zephray/Preader/hardware/front_pcb/front_pcb.kicad_pcb

## KiCad design hardware/front_pcb/front_pcb.kicad_pcb (2021-02-08)

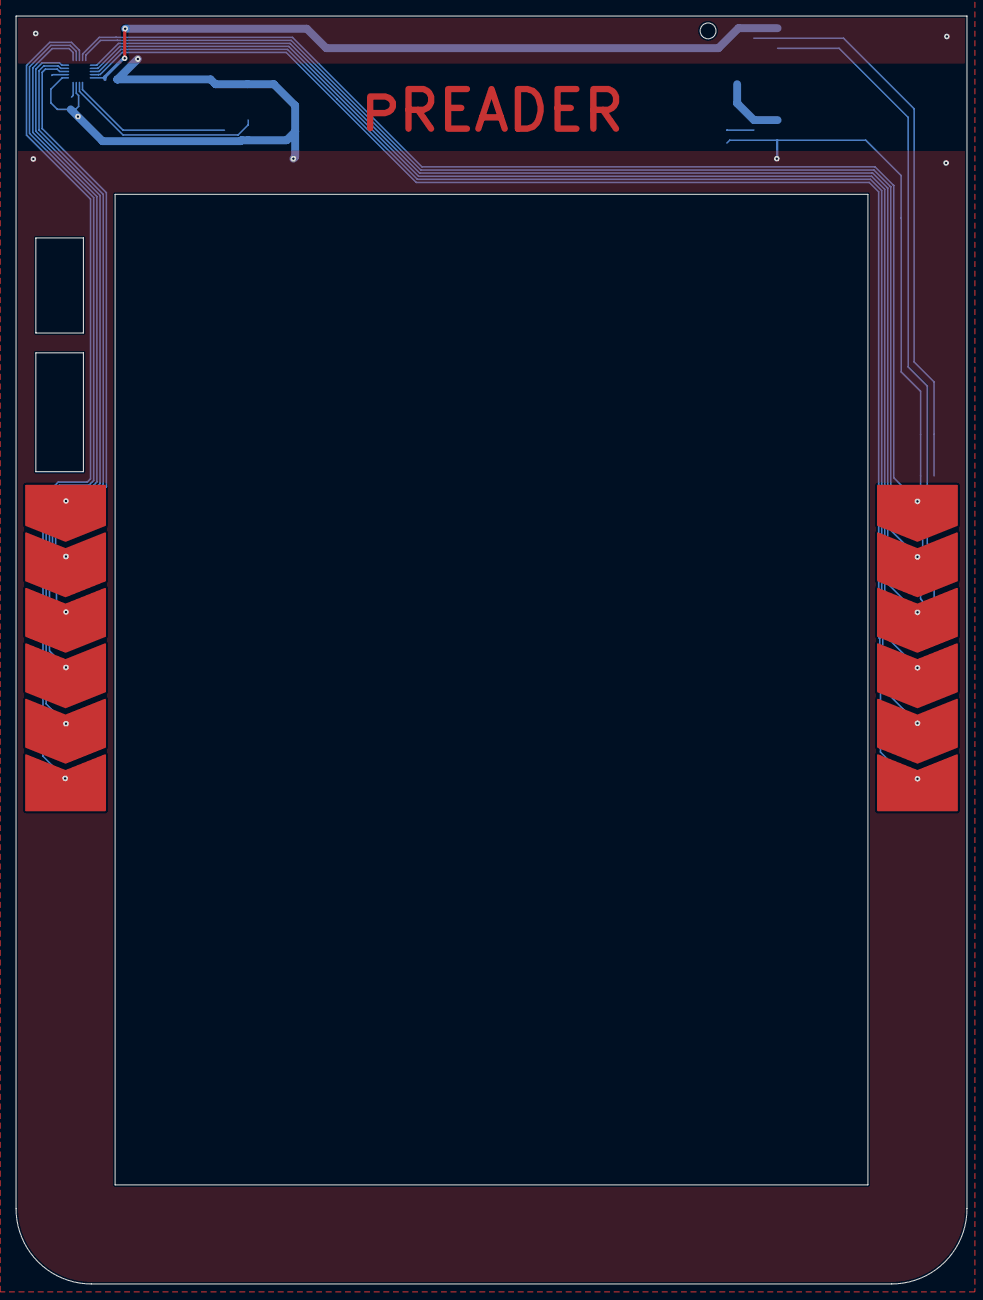
[picture p1: board front_pcb.kicad_pcb from above]

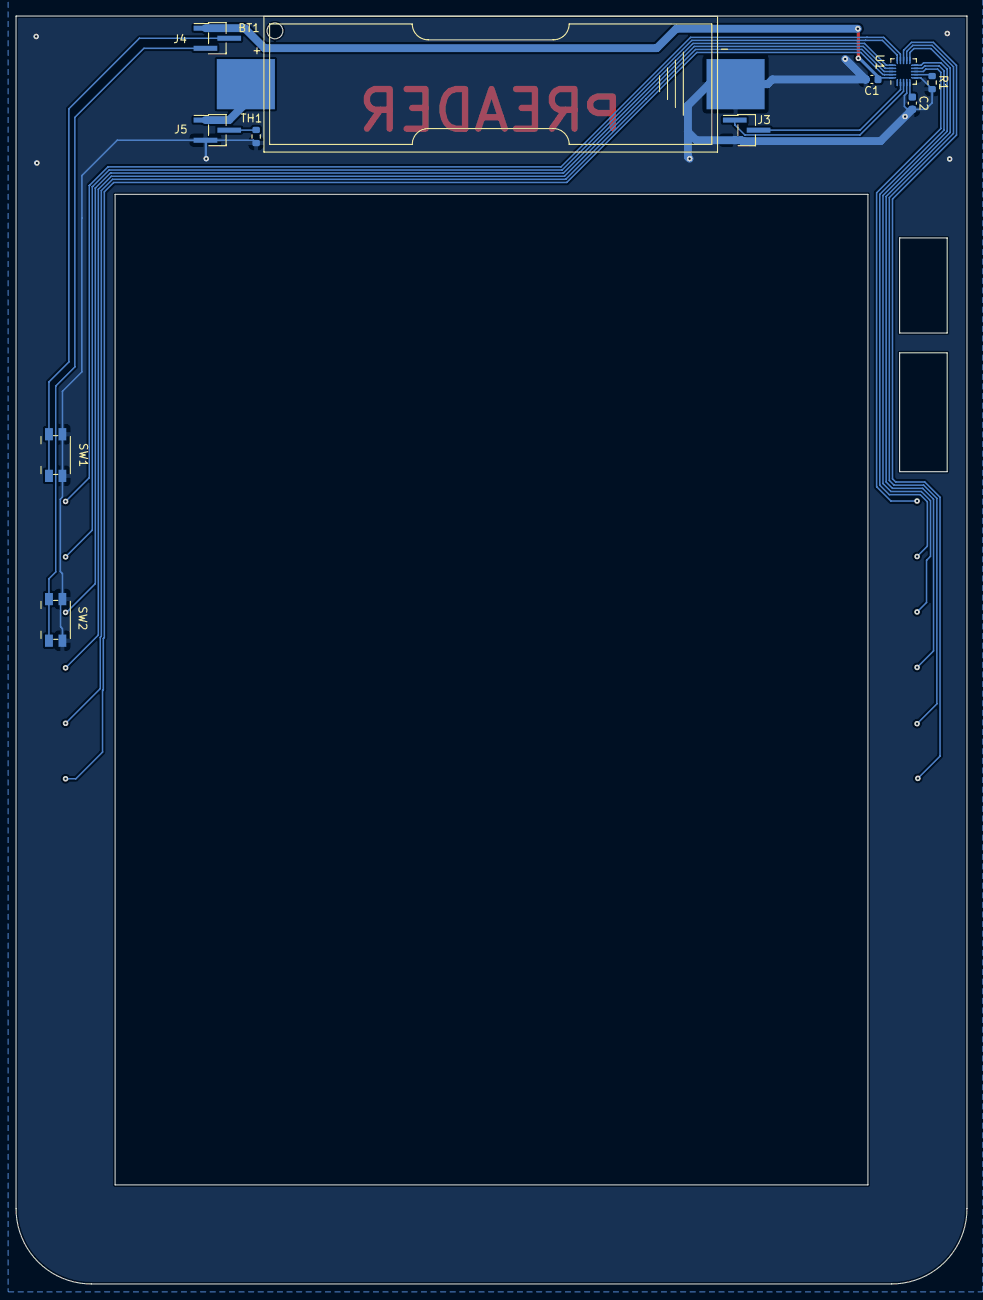
[picture p2: board front_pcb.kicad_pcb from below]

Board: 2 copper layers, 120.0 x 160.0 mm, 13 parts (11 on the bottom side), 22 nets.

Parts:
BT1: Keystone_1088_14800; BatteryHolder_Keystone_1088_1xAA
C1, C2: 100nF; C_0603_1608Metric
J1, J2: Conn_01x06; Touch_Sensing_6PADS
J3, J4, J5: Conn_01x03; PinHeader_1x03_P1.27mm_Vertical_SMD_Pin1Left
R1: 75K/1%; R_0603_1608Metric
SW1, SW2: EVQPUJ02K; Panasonic_EVQPUJ_EVQPUA
TH1: Thermistor_NTC; R_0603_1608Metric
U1: MPR121QR2; UQFN-20_3x3mm_P0.4mm

Connections:
+3V3: C1.1, J4.1, U1.20 (VDD)
+BATT: BT1.1 (+), J5.1
/KEY1: J4.2, SW1.1
/KEY2: J4.3, SW2.1
/KP_SCL: J3.1, U1.3 (SDA)
/KP_SDA: J3.2, U1.2 (SCL)
GND: BT1.2 (-), C1.2, C2.2, J3.3, J5.3, R1.2, SW1.2, SW2.2, TH1.2, U1.4 (ADDR), U1.6 (VSS)
unnamed: C2.1, U1.5 (VREG)
unnamed: J1.1, U1.8 (ELE0)
unnamed: J1.2, U1.9 (ELE1)
unnamed: J1.3, U1.10 (ELE2)
unnamed: J1.4, U1.11 (ELE3)
unnamed: J1.5, U1.12 (LED0/ELE4)
unnamed: J1.6, U1.13 (LED1/ELE5)
unnamed: J2.1, U1.14 (LED2/ELE6)
unnamed: J2.2, U1.15 (LED3/ELE7)
unnamed: J2.3, U1.16 (LED4/ELE8)
unnamed: J2.4, U1.17 (LED5/ELE9)
unnamed: J2.5, U1.18 (LED6/ELE10)
unnamed: J2.6, U1.19 (LED7/ELE11)
unnamed: R1.1, U1.7 (REXT)
unnamed: J5.2, TH1.1
