zephray/Preader/hardware/main_pcb/pcb.kicad_pcb

## KiCad design hardware/main_pcb/pcb.kicad_pcb (2021-02-08)

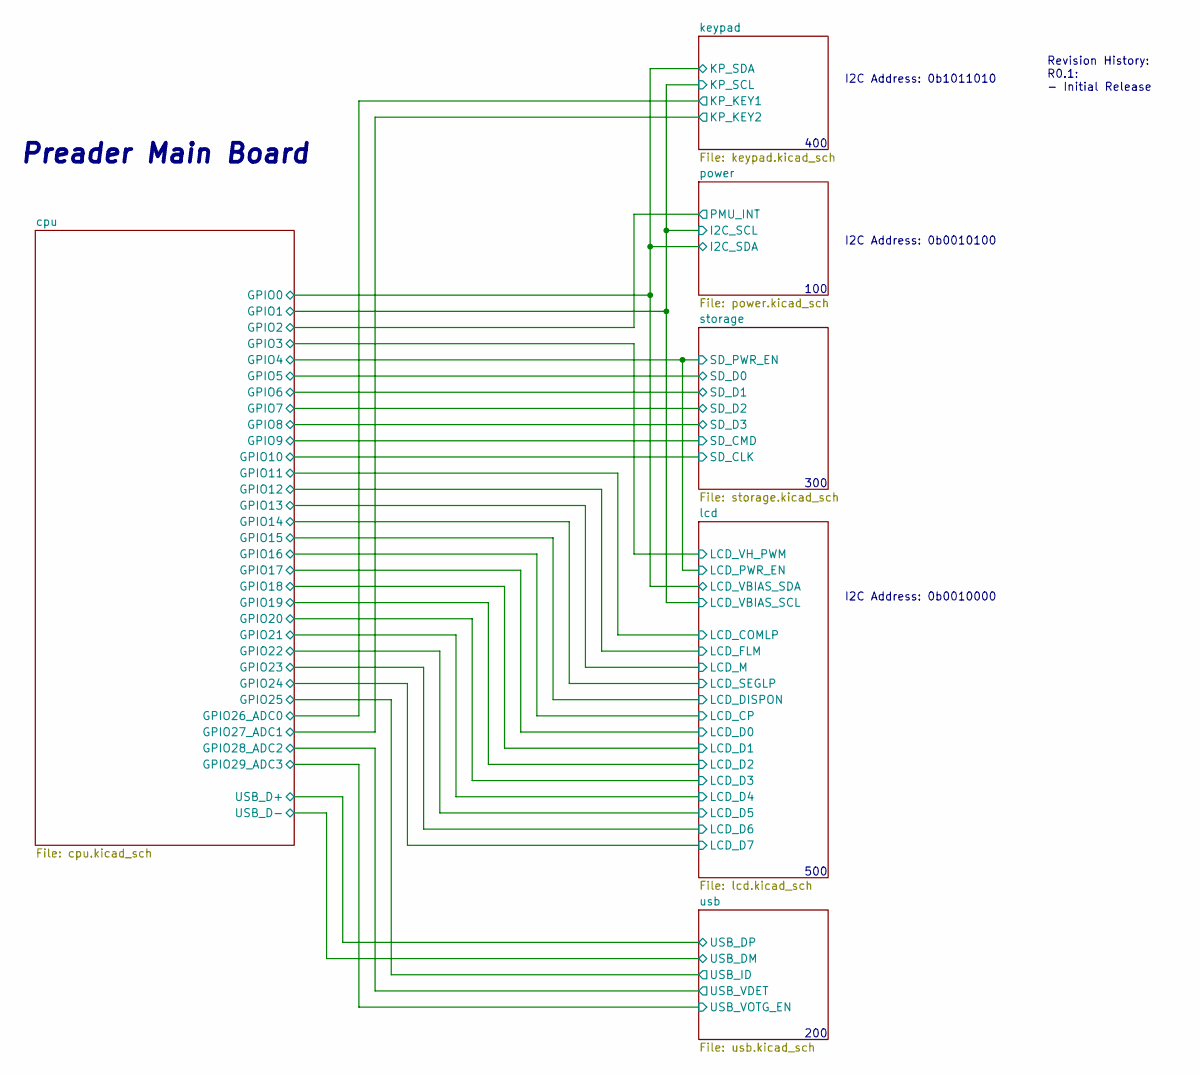
[picture p3: schematic pcb.kicad_sch, Preader MB]

Notes on the sheet:
Preader Main Board
400
100
300
500
200
I2C Address: 0b1011010
I2C Address: 0b0010100
I2C Address: 0b0010000
Revision History: R0.1: - Initial Release

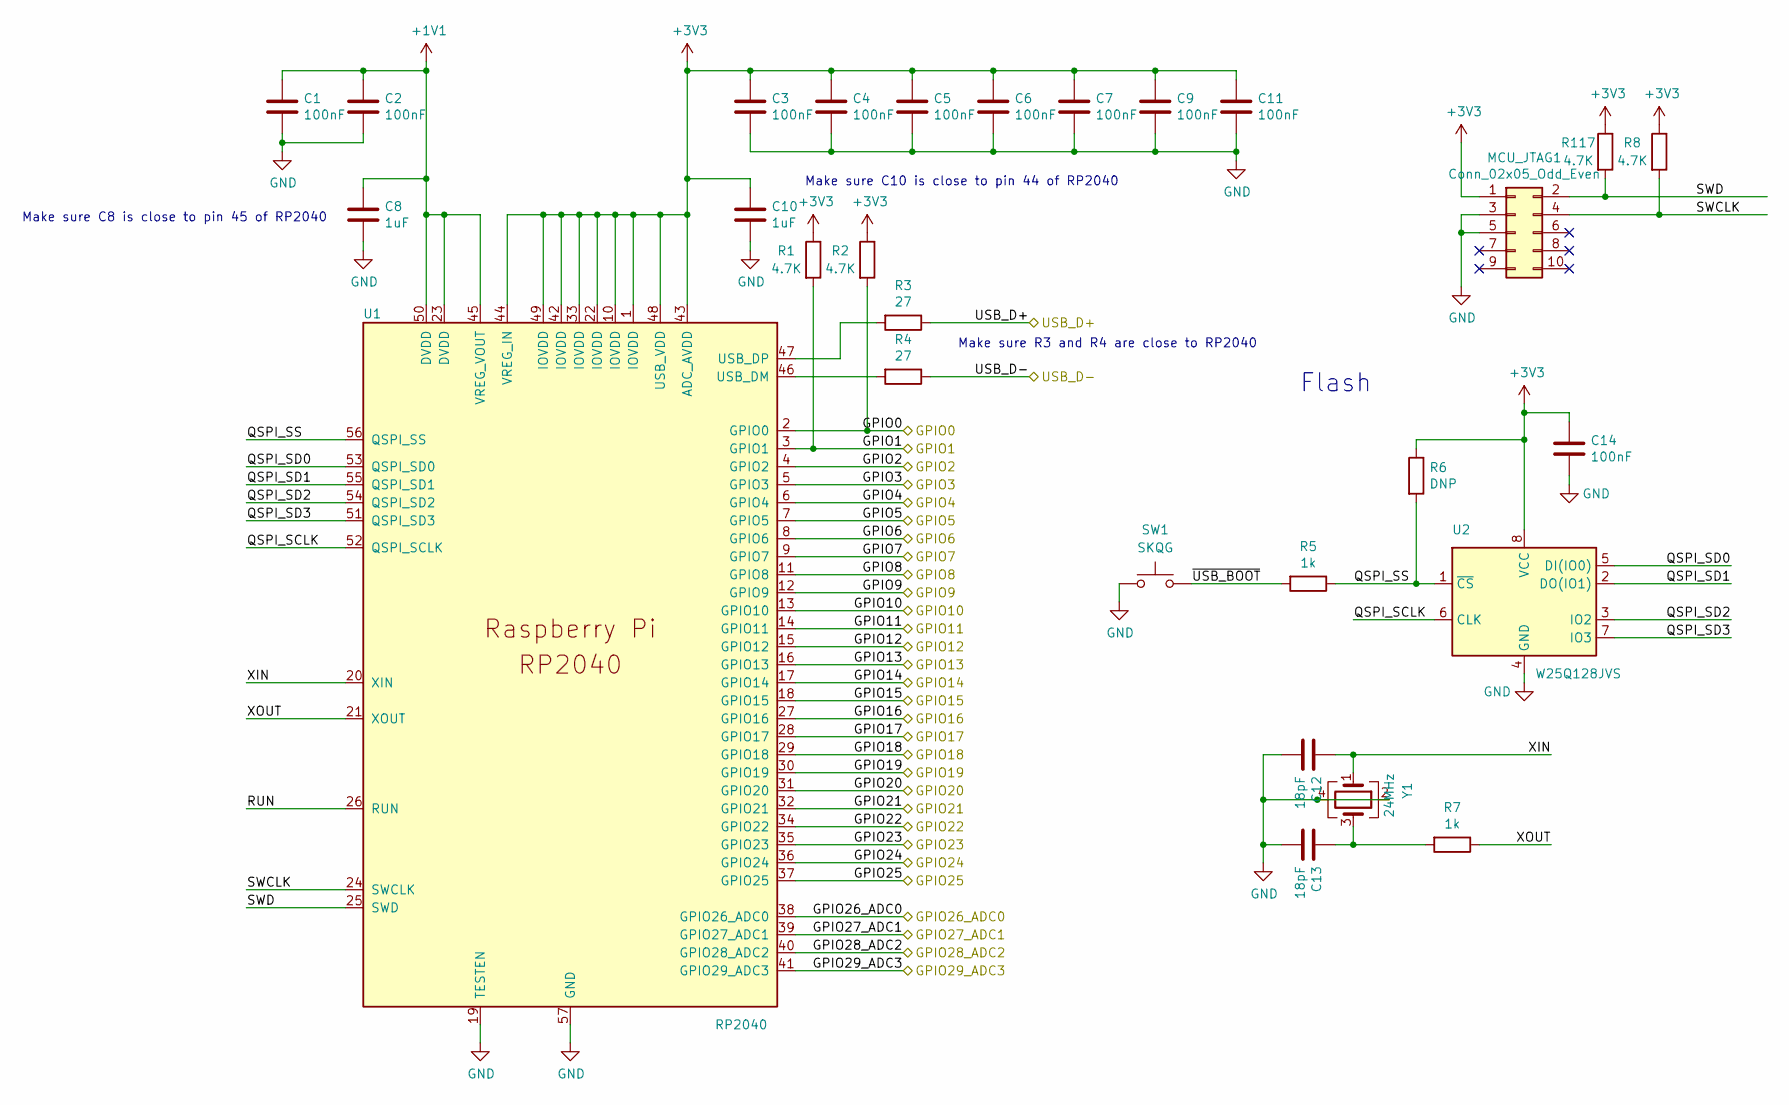
[picture p4: schematic cpu.kicad_sch, InuCal]

Parts:
C1, C2, C3, C4, C5, C6, C7, C9, C11, C14: 100nF; C_0402_1005Metric
C8, C10: 1uF; C_0402_1005Metric
C12, C13: 18pF; C_0402_1005Metric
MCU_JTAG1: Conn_02x05_Odd_Even; PinHeader_2x05_P1.27mm_Vertical_SMD
R1, R2, R8, R117: 4.7K; C_0402_1005Metric
R3, R4: 27; C_0402_1005Metric
R5, R7: 1k; C_0402_1005Metric
R6: DNP; C_0402_1005Metric
SW1: SKQG; SW_SPST_SKQG_WithStem
U1: RP2040; QFN-56-1EP_7x7mm_P0.4mm_EP5.6x5.6mm_ThermalVias
U2: W25Q128JVS; SOIC-8_5.23x5.23mm_P1.27mm
Y1: 24MHz; Oscillator_SMD_Abracon_ASE-4Pin_3.2x2.5mm

Connections:
+1V1: C1.1, C2.1, C8.1, U1.23 (DVDD), U1.45 (VREG_VOUT), U1.50 (DVDD)
+3V3: C3.1, C4.1, C5.1, C6.1, C7.1, C9.1, C10.1, C11.1, C14.1, MCU_JTAG1.1, R1.1, R2.1, R6.1, R8.1, R117.1, U1.1 (IOVDD), U1.10 (IOVDD), U1.22 (IOVDD), U1.33 (IOVDD), U1.42 (IOVDD), U1.43 (ADC_AVDD), U1.44 (VREG_IN), U1.48 (USB_VDD), U1.49 (IOVDD), U2.8 (VCC); also elsewhere on the board
/cpu/GPIO0: R2.2, U1.2 (GPIO0); also elsewhere on the board
/cpu/GPIO1: R1.2, U1.3 (GPIO1); also elsewhere on the board
/cpu/GPIO2: U1.4 (GPIO2); also elsewhere on the board
/cpu/GPIO3: U1.5 (GPIO3); also elsewhere on the board
/cpu/GPIO4: U1.6 (GPIO4); also elsewhere on the board
/cpu/GPIO5: U1.7 (GPIO5); also elsewhere on the board
/cpu/GPIO6: U1.8 (GPIO6); also elsewhere on the board
/cpu/GPIO7: U1.9 (GPIO7); also elsewhere on the board
/cpu/GPIO8: U1.11 (GPIO8); also elsewhere on the board
/cpu/GPIO9: U1.12 (GPIO9); also elsewhere on the board
/cpu/GPIO10: U1.13 (GPIO10); also elsewhere on the board
/cpu/GPIO11: U1.14 (GPIO11); also elsewhere on the board
/cpu/GPIO12: U1.15 (GPIO12); also elsewhere on the board
/cpu/GPIO13: U1.16 (GPIO13); also elsewhere on the board
/cpu/GPIO14: U1.17 (GPIO14); also elsewhere on the board
/cpu/GPIO15: U1.18 (GPIO15); also elsewhere on the board
/cpu/GPIO16: U1.27 (GPIO16); also elsewhere on the board
/cpu/GPIO17: U1.28 (GPIO17); also elsewhere on the board
/cpu/GPIO18: U1.29 (GPIO18); also elsewhere on the board
/cpu/GPIO19: U1.30 (GPIO19); also elsewhere on the board
/cpu/GPIO20: U1.31 (GPIO20); also elsewhere on the board
/cpu/GPIO21: U1.32 (GPIO21); also elsewhere on the board
/cpu/GPIO22: U1.34 (GPIO22); also elsewhere on the board
/cpu/GPIO23: U1.35 (GPIO23); also elsewhere on the board
/cpu/GPIO24: U1.36 (GPIO24); also elsewhere on the board
/cpu/GPIO25: U1.37 (GPIO25); also elsewhere on the board
/cpu/GPIO26_ADC0: U1.38 (GPIO26_ADC0); also elsewhere on the board
/cpu/GPIO27_ADC1: U1.39 (GPIO27_ADC1); also elsewhere on the board
/cpu/GPIO28_ADC2: U1.40 (GPIO28_ADC2); also elsewhere on the board
/cpu/GPIO29_ADC3: U1.41 (GPIO29_ADC3); also elsewhere on the board
/cpu/QSPI_SCLK: U1.52 (QSPI_SCLK), U2.6 (CLK)
/cpu/QSPI_SD0: U1.53 (QSPI_SD0), U2.5 (DI(IO0))
/cpu/QSPI_SD1: U1.55 (QSPI_SD1), U2.2 (DO(IO1))
/cpu/QSPI_SD2: U1.54 (QSPI_SD2), U2.3 (IO2)
/cpu/QSPI_SD3: U1.51 (QSPI_SD3), U2.7 (IO3)
/cpu/QSPI_SS: R5.1, R6.2, U1.56 (QSPI_SS), U2.1 (~CS)
/cpu/RUN: U1.26 (RUN)
/cpu/SWCLK: MCU_JTAG1.4, R8.2, U1.24 (SWCLK)
/cpu/SWD: MCU_JTAG1.2, R117.2, U1.25 (SWD)
/cpu/USB_D+: R3.1; also elsewhere on the board
/cpu/USB_D-: R4.1; also elsewhere on the board
/cpu/XIN: C12.1, U1.20 (XIN), Y1.1
/cpu/XOUT: R7.1, U1.21 (XOUT)
/cpu/~USB_BOOT: R5.2, SW1.2
GND: C1.2, C2.2, C3.2, C4.2, C5.2, C6.2, C7.2, C8.2, C9.2, C10.2, C11.2, C12.2, C13.2, C14.2, MCU_JTAG1.3, MCU_JTAG1.5, SW1.1, U1.19 (TESTEN), U1.57 (GND), U2.4 (GND), Y1.2, Y1.4; also elsewhere on the board
unnamed: C13.1, R7.2, Y1.3
unnamed: R3.2, U1.47 (USB_DP)
unnamed: R4.2, U1.46 (USB_DM)

Notes on the sheet:
Make sure C8 is close to pin 45 of RP2040
Make sure C10 is close to pin 44 of RP2040
Make sure R3 and R4 are close to RP2040
Flash

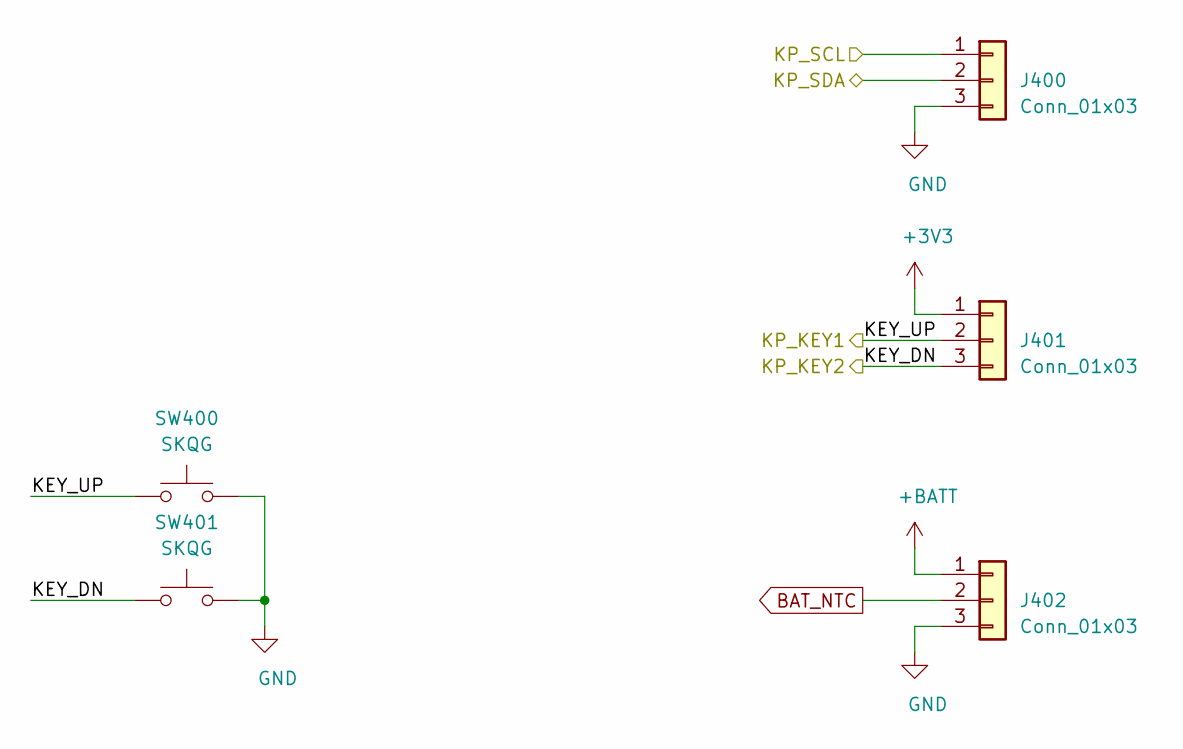
[picture p5: schematic keypad.kicad_sch, InuCal]

Parts:
J400, J401, J402: Conn_01x03; PinHeader_1x03_P1.27mm_Vertical
SW400, SW401: SKQG; SW_SPST_SKQG_WithStem

Connections:
+3V3: J401.1; also elsewhere on the board
+BATT: J402.1; also elsewhere on the board
/cpu/GPIO0: J400.2; also elsewhere on the board
/cpu/GPIO1: J400.1; also elsewhere on the board
/cpu/GPIO26_ADC0: J401.2, SW400.1; also elsewhere on the board
/cpu/GPIO27_ADC1: J401.3, SW401.1; also elsewhere on the board
BAT_NTC: J402.2; also elsewhere on the board
GND: J400.3, J402.3, SW400.2, SW401.2; also elsewhere on the board

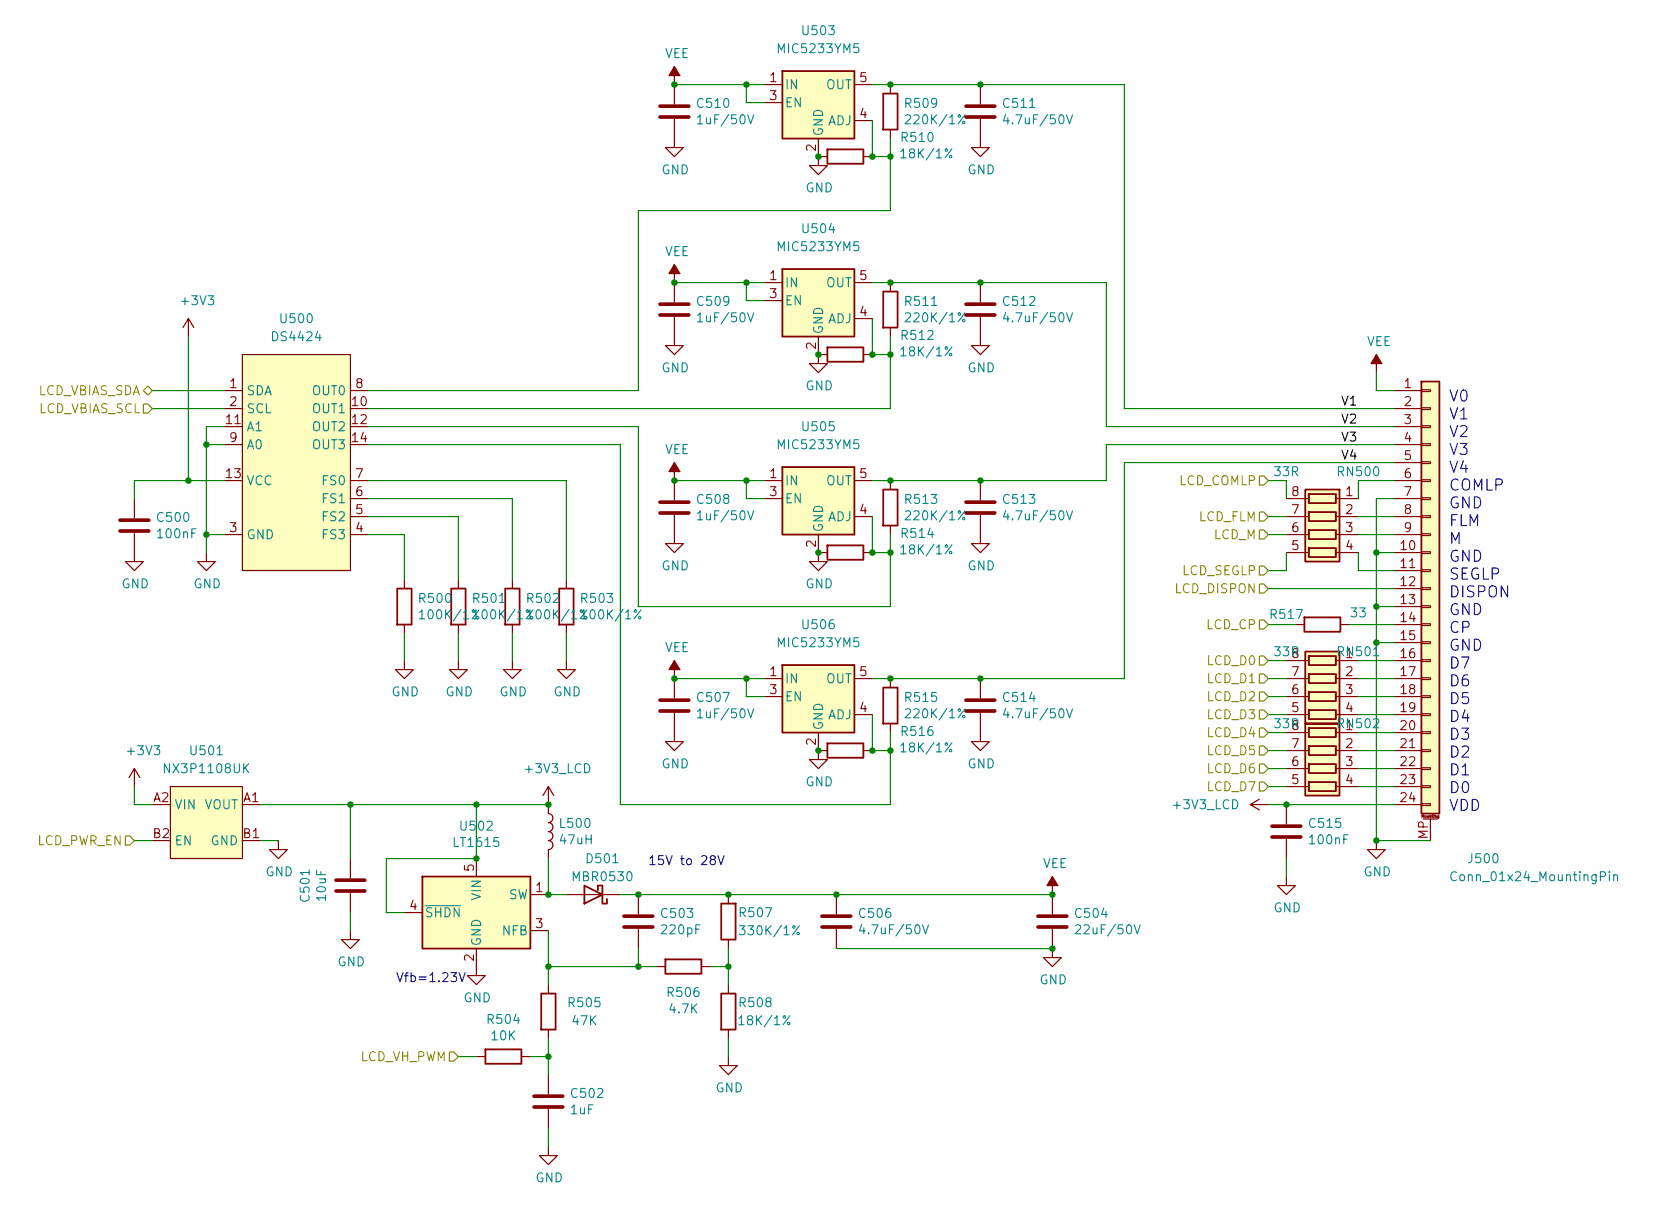
[picture p6: schematic lcd.kicad_sch, InuCal]

Parts:
C500, C515: 100nF; C_0402_1005Metric
C501: 10uF; C_0603_1608Metric
C502: 1uF; C_0402_1005Metric
C503: 220pF; C_0603_1608Metric
C504: 22uF/50V; C_1206_3216Metric
C506, C511, C512, C513, C514: 4.7uF/50V; C_0805_2012Metric
C507, C508, C509, C510: 1uF/50V; C_0805_2012Metric
D501: MBR0530; D_SOD-123
J500: Conn_01x24_MountingPin; Hirose_FH12-24S-0.5SH_1x24-1MP_P0.50mm_Horizontal
L500: 47uH; L_Vishay_IHLP-1212
R500, R501, R502, R503: 100K/1%; R_0402_1005Metric
R504: 10K; R_0402_1005Metric
R505: 47K; R_0402_1005Metric
R506: 4.7K; R_0402_1005Metric
R507: 330K/1%; R_0402_1005Metric
R508, R510, R512, R514, R516: 18K/1%; R_0402_1005Metric
R509, R511, R513, R515: 220K/1%; R_0402_1005Metric
R517: 33; R_0402_1005Metric
RN500, RN501, RN502: 33R; R_Array_Convex_4x0402
U500: DS4424; DFN-14-1EP_3x3mm_P0.4mm_EP1.78x2.35mm
U501: NX3P1108UK; WLCSP-4-X1-WLB0909-4_0.89x0.89mm_P0.5mm
U502: LT1615; TSOT-23-5
U503, U504, U505, U506: MIC5233YM5; SOT-23-5

Connections:
+3V3: C500.2, U500.13 (VCC), U501.A2 (VIN); also elsewhere on the board
+3V3_LCD: C501.1, C515.2, J500.24, L500.1, U501.A1 (VOUT), U502.4 (~SHDN), U502.5 (VIN)
/cpu/GPIO0: U500.1 (SDA); also elsewhere on the board
/cpu/GPIO1: U500.2 (SCL); also elsewhere on the board
/cpu/GPIO3: R504.2; also elsewhere on the board
/cpu/GPIO4: U501.B2 (EN); also elsewhere on the board
/cpu/GPIO11: RN500.8 (R1.2); also elsewhere on the board
/cpu/GPIO12: RN500.7 (R2.2); also elsewhere on the board
/cpu/GPIO13: RN500.6 (R3.2); also elsewhere on the board
/cpu/GPIO14: RN500.5 (R4.2); also elsewhere on the board
/cpu/GPIO15: J500.12; also elsewhere on the board
/cpu/GPIO16: R517.2; also elsewhere on the board
/cpu/GPIO17: RN501.8 (R1.2); also elsewhere on the board
/cpu/GPIO18: RN501.7 (R2.2); also elsewhere on the board
/cpu/GPIO19: RN501.6 (R3.2); also elsewhere on the board
/cpu/GPIO20: RN501.5 (R4.2); also elsewhere on the board
/cpu/GPIO21: RN502.8 (R1.2); also elsewhere on the board
/cpu/GPIO22: RN502.7 (R2.2); also elsewhere on the board
/cpu/GPIO23: RN502.6 (R3.2); also elsewhere on the board
/cpu/GPIO24: RN502.5 (R4.2); also elsewhere on the board
/lcd/V1: C511.2, J500.2, R509.1, U503.5 (OUT)
/lcd/V2: C512.2, J500.3, R511.1, U504.5 (OUT)
/lcd/V3: C513.2, J500.4, R513.1, U505.5 (OUT)
/lcd/V4: C514.2, J500.5, R515.1, U506.5 (OUT)
GND: C500.1, C501.2, C502.1, C504.2, C506.1, C507.1, C508.1, C509.1, C510.1, C511.1, C512.1, C513.1, C514.1, C515.1, J500.7, J500.10, J500.13, J500.15, J500.MP (MountPin), R500.2, R501.2, R502.2, R503.2, R508.2, R510.2, R512.2, R514.2, R516.2, U500.3 (GND), U500.9 (A0), U500.11 (A1), U501.B1 (GND), U502.2 (GND), U503.2 (GND), U504.2 (GND), U505.2 (GND), U506.2 (GND); also elsewhere on the board
unnamed: C502.2, R504.1, R505.2
unnamed: C503.1, R505.1, R506.2, U502.3 (NFB)
unnamed: D501.2 (A), L500.2, U502.1 (SW)
unnamed: J500.6, RN500.1 (R1.1)
unnamed: J500.8, RN500.2 (R2.1)
unnamed: J500.9, RN500.3 (R3.1)
unnamed: J500.11, RN500.4 (R4.1)
unnamed: J500.14, R517.1
unnamed: J500.16, RN501.1 (R1.1)
unnamed: J500.17, RN501.2 (R2.1)
unnamed: J500.18, RN501.3 (R3.1)
unnamed: J500.19, RN501.4 (R4.1)
unnamed: J500.20, RN502.1 (R1.1)
unnamed: J500.21, RN502.2 (R2.1)
unnamed: J500.22, RN502.3 (R3.1)
unnamed: J500.23, RN502.4 (R4.1)
unnamed: R500.1, U500.4 (FS3)
unnamed: R501.1, U500.5 (FS2)
unnamed: R502.1, U500.6 (FS1)
unnamed: R503.1, U500.7 (FS0)
unnamed: R506.1, R507.1, R508.1
unnamed: R509.2, R510.1, U500.8 (OUT0), U503.4 (ADJ)
unnamed: R511.2, R512.1, U500.10 (OUT1), U504.4 (ADJ)
unnamed: R513.2, R514.1, U500.12 (OUT2), U505.4 (ADJ)
unnamed: R515.2, R516.1, U500.14 (OUT3), U506.4 (ADJ)
VEE: C503.2, C504.1, C506.2, C507.2, C508.2, C509.2, C510.2, D501.1 (K), J500.1, R507.2, U503.1 (IN), U503.3 (EN), U504.1 (IN), U504.3 (EN), U505.1 (IN), U505.3 (EN), U506.1 (IN), U506.3 (EN)

Notes on the sheet:
Vfb=1.23V
15V to 28V
V0 V1 V2 V3 V4 COMLP GND FLM M GND SEGLP DISPON GND CP GND D7 D6 D5 D4 D3 D2 D1 D0 VDD

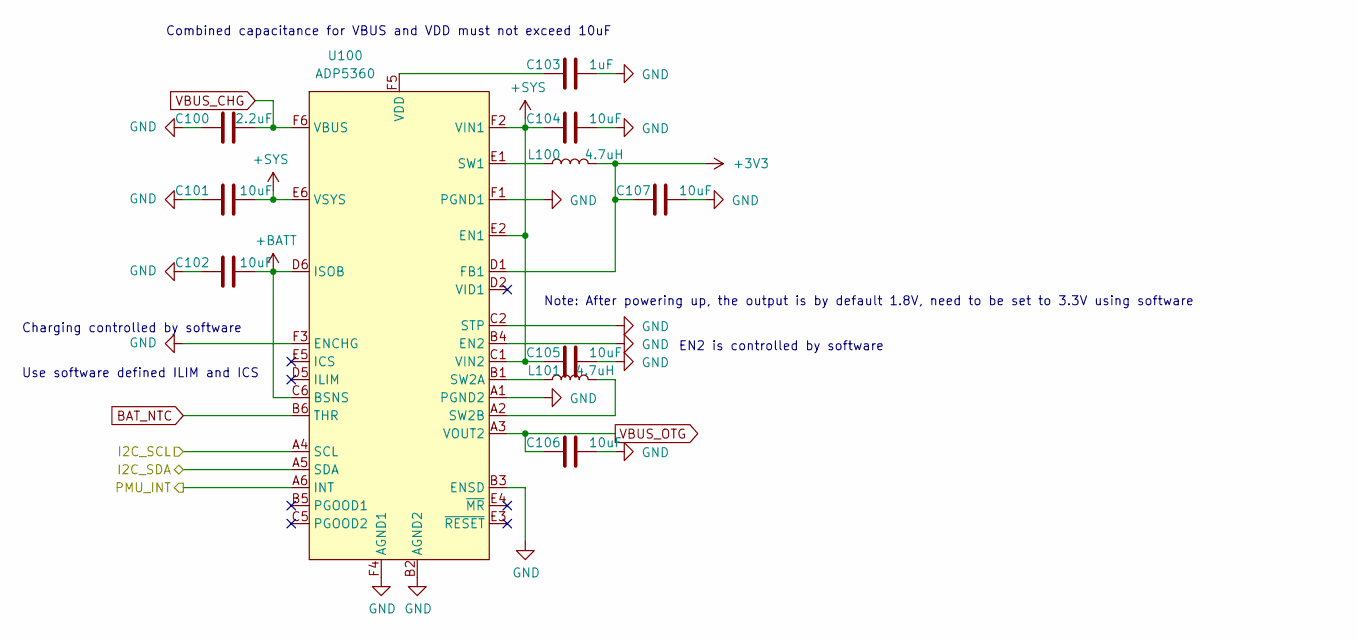
[picture p7: schematic power.kicad_sch, InuCal]

Parts:
C100: 2.2uF; C_0603_1608Metric
C101, C102, C104, C105, C106, C107: 10uF; C_0603_1608Metric
C103: 1uF; C_0402_1005Metric
L100, L101: 4.7uH; L_Vishay_IHLP-1212
U100: ADP5360; WLCSP-32_6x6_2.56x2.56mm

Connections:
+3V3: C107.2, L100.2, U100.D1 (FB1); also elsewhere on the board
+BATT: C102.2, U100.C6 (BSNS), U100.D6 (ISOB); also elsewhere on the board
+SYS: C101.2, C104.2, C105.2, U100.C1 (VIN2), U100.E2 (EN1), U100.E6 (VSYS), U100.F2 (VIN1)
/cpu/GPIO0: U100.A5 (SDA); also elsewhere on the board
/cpu/GPIO1: U100.A4 (SCL); also elsewhere on the board
/cpu/GPIO2: U100.A6 (INT); also elsewhere on the board
BAT_NTC: U100.B6 (THR); also elsewhere on the board
GND: C100.1, C101.1, C102.1, C103.1, C104.1, C105.1, C106.1, C107.1, U100.A1 (PGND2), U100.B2 (AGND2), U100.B3 (ENSD), U100.B4 (EN2), U100.C2 (STP), U100.F1 (PGND1), U100.F3 (ENCHG), U100.F4 (AGND1); also elsewhere on the board
unnamed: C103.2, U100.F5 (VDD)
unnamed: L100.1, U100.E1 (SW1)
unnamed: L101.1, U100.B1 (SW2A)
unnamed: L101.2, U100.A2 (SW2B)
VBUS_CHG: C100.2, U100.F6 (VBUS); also elsewhere on the board
VBUS_OTG: C106.2, U100.A3 (VOUT2); also elsewhere on the board

Notes on the sheet:
Charging controlled by software
Use software defined ILIM and ICS
Combined capacitance for VBUS and VDD must not exceed 10uF
Note: After powering up, the output is by default 1.8V, need to be set to 3.3V using software
EN2 is controlled by software

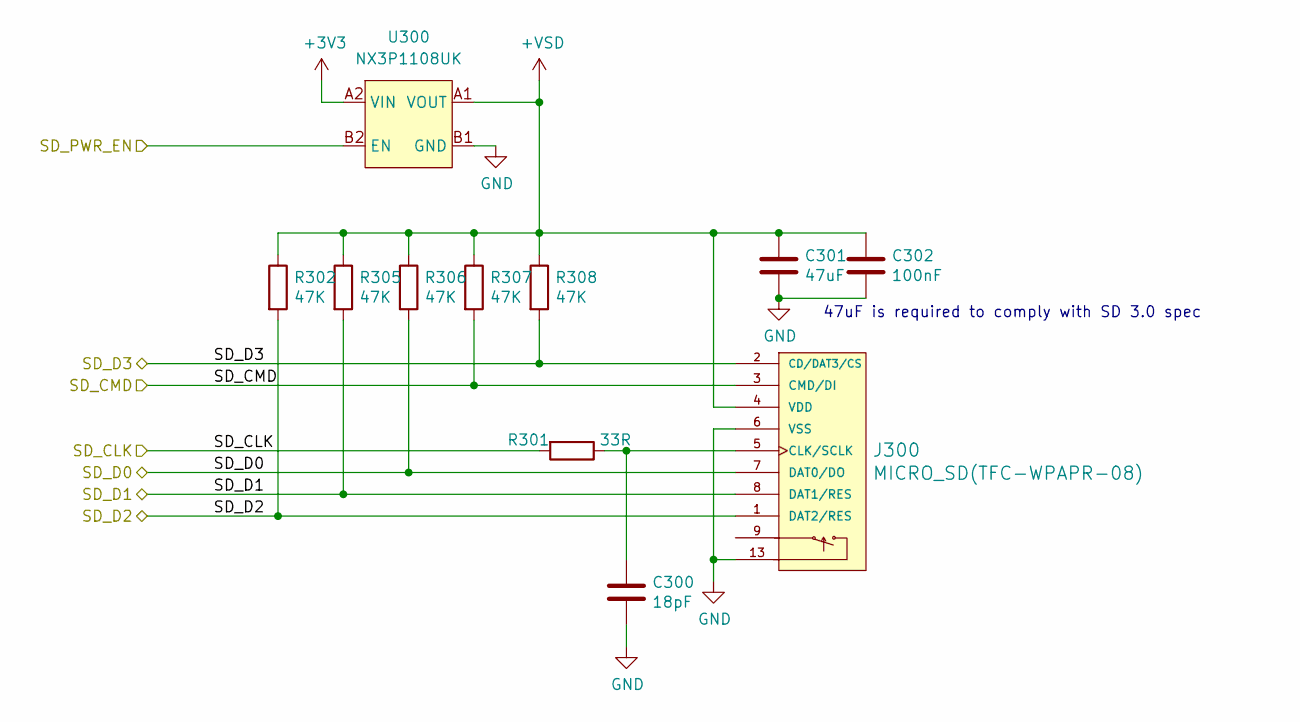
[picture p8: schematic storage.kicad_sch, InuCal]

Parts:
C300: 18pF; C_0402_1005Metric
C301: 47uF; C_0805_2012Metric
C302: 100nF; C_0402_1005Metric
J300: MICRO_SD(TFC-WPAPR-08); TFC-WPAPR-08
R301: 33R; R_0402_1005Metric
R302, R305, R306, R307, R308: 47K; R_0402_1005Metric
U300: NX3P1108UK; WLCSP-4-X1-WLB0909-4_0.89x0.89mm_P0.5mm

Connections:
+3V3: U300.A2 (VIN); also elsewhere on the board
+VSD: C301.1, C302.1, J300.4 (VDD), R302.1, R305.1, R306.1, R307.1, R308.1, U300.A1 (VOUT)
/cpu/GPIO4: U300.B2 (EN); also elsewhere on the board
/cpu/GPIO5: J300.7 (DAT0/DO), R306.2; also elsewhere on the board
/cpu/GPIO6: J300.8 (DAT1/RES), R305.2; also elsewhere on the board
/cpu/GPIO7: J300.1 (DAT2/RES), R302.2; also elsewhere on the board
/cpu/GPIO8: J300.2 (CD/DAT3/CS), R308.2; also elsewhere on the board
/cpu/GPIO9: J300.3 (CMD/DI), R307.2; also elsewhere on the board
/cpu/GPIO10: R301.2; also elsewhere on the board
GND: C300.2, C301.2, C302.2, J300.6 (VSS), J300.10, J300.11, J300.12, J300.13, U300.B1 (GND); also elsewhere on the board
unnamed: C300.1, J300.5 (CLK/SCLK), R301.1

Notes on the sheet:
47uF is required to comply with SD 3.0 spec

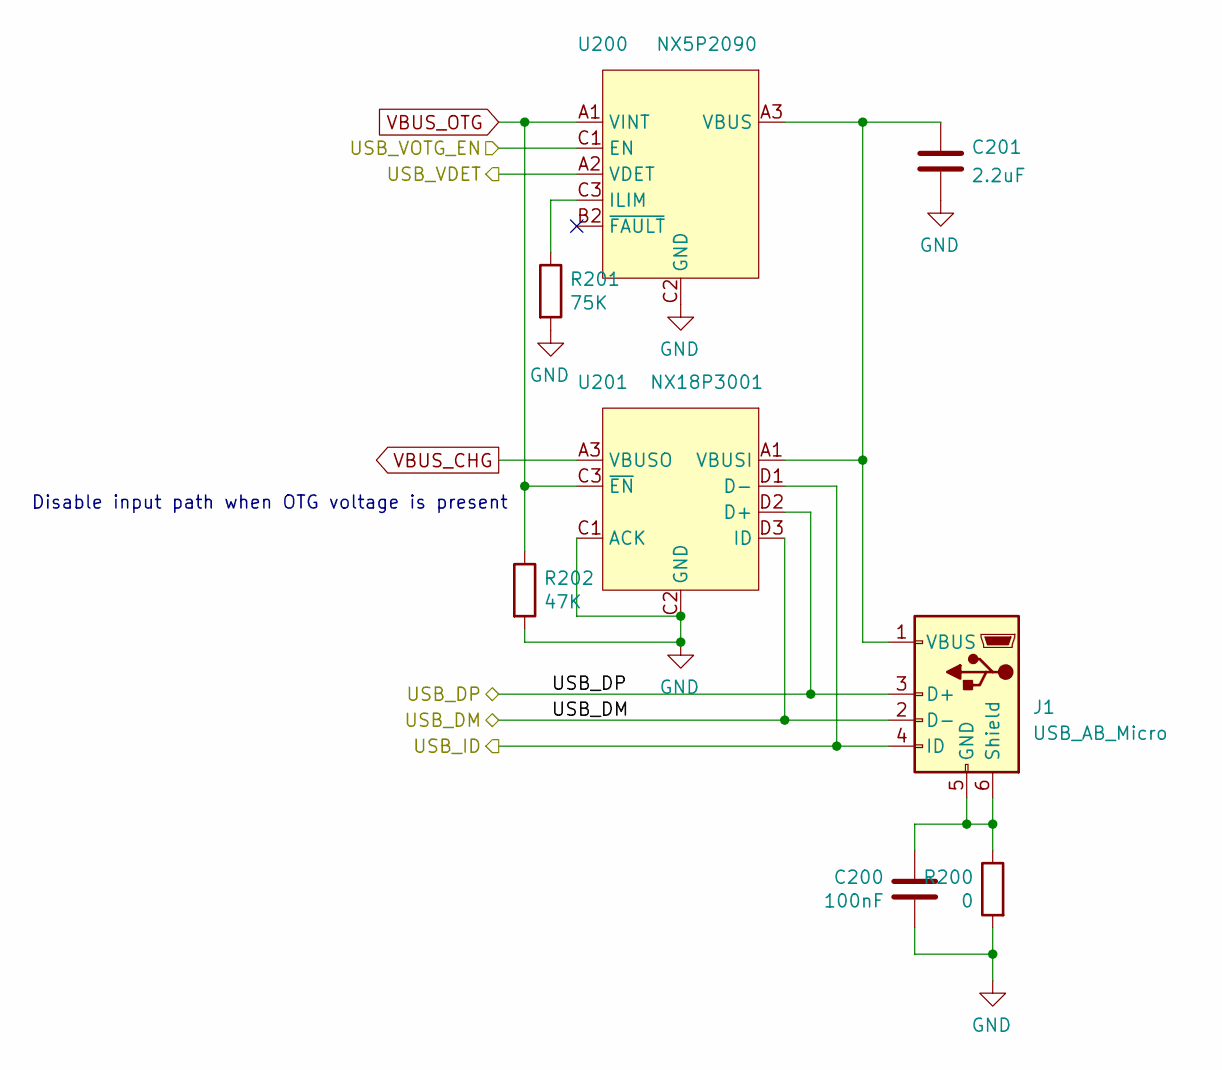
[picture p9: schematic usb.kicad_sch, InuCal]

Parts:
C200: 100nF; C_0805_2012Metric
C201: 2.2uF; C_0603_1608Metric
J1: USB_AB_Micro; USB_Micro-AB_Molex_47590-0001
R200: 0; R_0805_2012Metric
R201: 75K; R_0402_1005Metric
R202: 47K; R_0402_1005Metric
U200: NX5P2090; WLCSP-9_3x3_1.36x1.36mm
U201: NX18P3001; WLCSP-12_3x4_1.36x1.66mm

Connections:
/cpu/GPIO25: J1.4 (ID), U201.D1 (D-); also elsewhere on the board
/cpu/GPIO28_ADC2: U200.A2 (VDET); also elsewhere on the board
/cpu/GPIO29_ADC3: U200.C1 (EN); also elsewhere on the board
/cpu/USB_D+: J1.3 (D+), U201.D2 (D+); also elsewhere on the board
/cpu/USB_D-: J1.2 (D-), U201.D3 (ID); also elsewhere on the board
GND: C200.2, C201.1, R200.2, R201.2, R202.2, U200.C2 (GND), U201.C1 (ACK), U201.C2 (GND); also elsewhere on the board
unnamed: C200.1, J1.5 (GND), J1.6 (Shield), R200.1
unnamed: C201.2, J1.1 (VBUS), U200.A3 (VBUS), U200.B3 (VBUS), U201.A1 (VBUSI), U201.A2 (VBUSI), U201.B1 (VBUSI)
unnamed: R201.1, U200.C3 (ILIM)
VBUS_CHG: U201.A3 (VBUSO), U201.B2 (VBUSO), U201.B3 (VBUSO); also elsewhere on the board
VBUS_OTG: R202.1, U200.A1 (VINT), U200.B1 (VINT), U201.C3 (~EN); also elsewhere on the board

Notes on the sheet:
Disable input path when OTG voltage is present

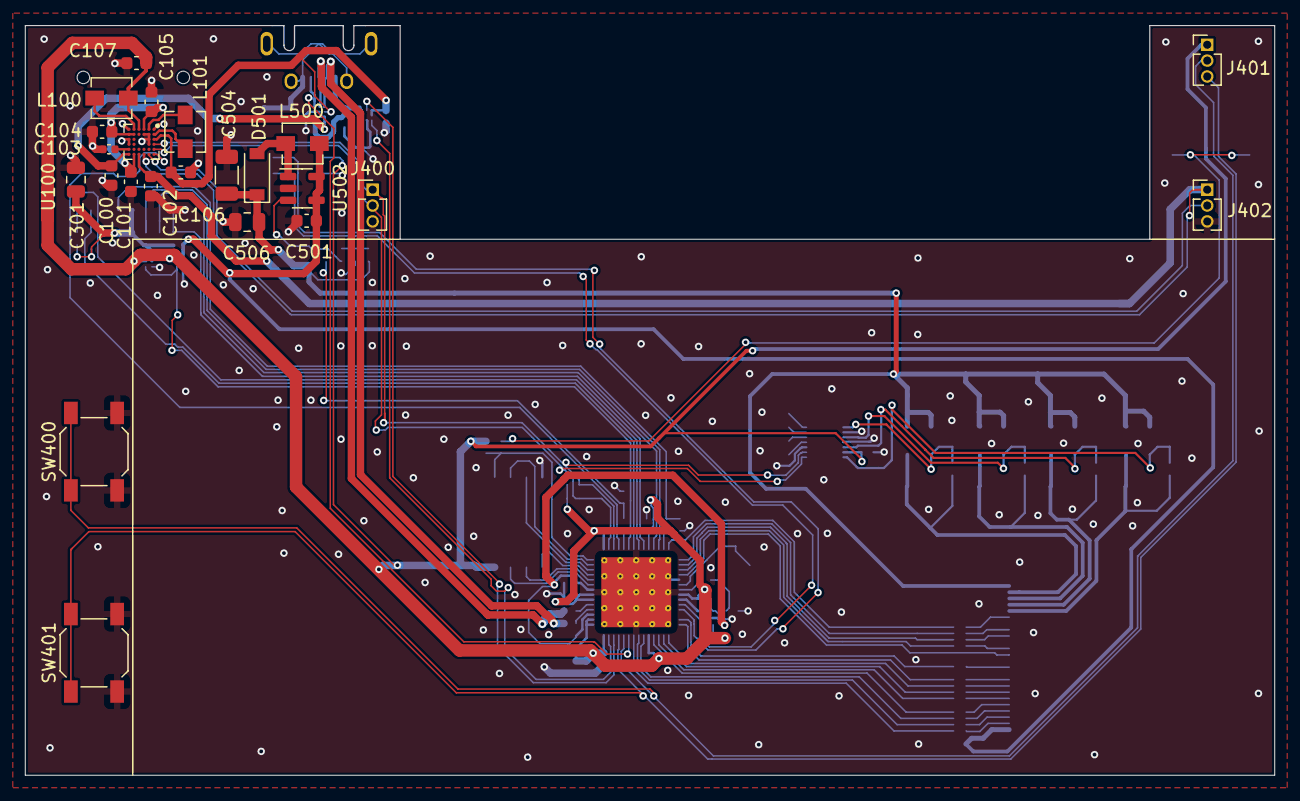
[picture p10: board pcb.kicad_pcb from above]

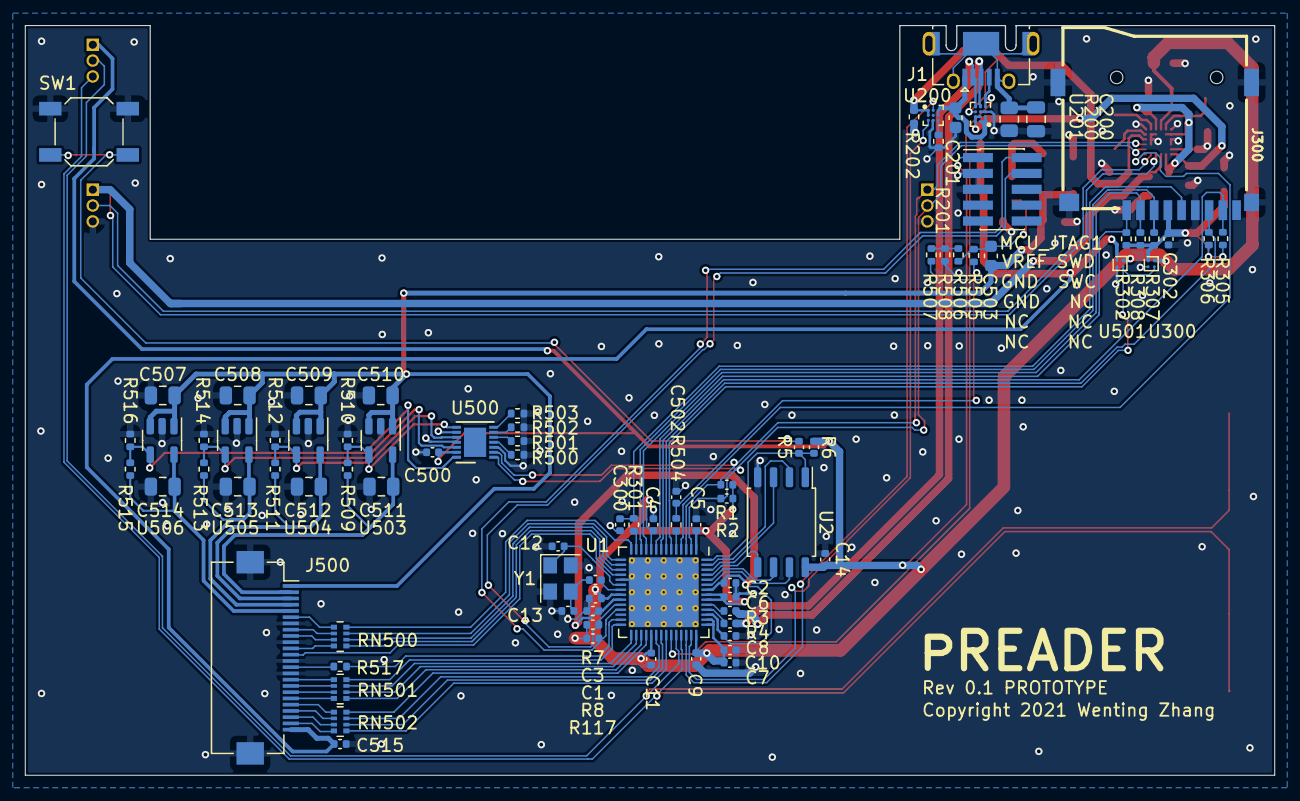
[picture p11: board pcb.kicad_pcb from below]

Board: 2 copper layers, 100.0 x 60.0 mm, 109 parts (86 on the bottom side), 94 nets.
