zephray/Preader/firmware/board/preader.h

/*
 * Copyright (c) 2020 Raspberry Pi (Trading) Ltd.
 *
 * SPDX-License-Identifier: BSD-3-Clause
 */

// -----------------------------------------------------
// NOTE: THIS HEADER IS ALSO INCLUDED BY ASSEMBLER SO
//       SHOULD ONLY CONSIST OF PREPROCESSOR DIRECTIVES
// -----------------------------------------------------

#ifndef _BOARDS_PREADER_H
#define _BOARDS_PREADER_H

// Default I2C
#ifndef PICO_DEFAULT_I2C
#define PICO_DEFAULT_I2C       0
#endif
#ifndef PICO_DEFAULT_I2C_SDA_PIN
#define PICO_DEFAULT_I2C_SDA_PIN   0
#endif
#ifndef PICO_DEFAULT_I2C_SCL_PIN
#define PICO_DEFAULT_I2C_SCL_PIN   1
#endif

#define PICO_BOOT_STAGE2_CHOOSE_W25Q080 1

#ifndef PICO_FLASH_SPI_CLKDIV
#define PICO_FLASH_SPI_CLKDIV 4
#endif

// board has 16M onboard flash
#ifndef PICO_FLASH_SIZE_BYTES
#define PICO_FLASH_SIZE_BYTES (4 * 1024 * 1024)
#endif

// B0 or B1 silicon

#ifndef PICO_FLOAT_SUPPORT_ROM_V1
#define PICO_FLOAT_SUPPORT_ROM_V1 1
#endif

#ifndef PICO_DOUBLE_SUPPORT_ROM_V1
#define PICO_DOUBLE_SUPPORT_ROM_V1 1
#endif

#endif
