zephray/Preader/(commit log)

2021-02-02 - R0P1 schematic draft
    [cpu.kicad_sch, keypad.kicad_sch, lcd.kicad_sch, pcb.kicad_pcb, pcb.kicad_sch, power.kicad_sch, storage.kicad_sch, usb.kicad_sch]
2021-02-02 - Rename pcb to main_pcb
    [cpu.kicad_sch, keypad.kicad_sch, lcd.kicad_sch, pcb.kicad_pcb, pcb.kicad_sch, power.kicad_sch, storage.kicad_sch, usb.kicad_sch]
2021-02-05 - Initial PCB layout
    [cpu.kicad_sch, front_pcb.kicad_pcb, front_pcb.kicad_sch, keypad.kicad_sch, lcd.kicad_sch, pcb.kicad_pcb, pcb.kicad_sch, power.kicad_sch]
2021-02-07 - PCB rev 0p1 draft
    [front_pcb.kicad_pcb, lcd.kicad_sch, pcb.kicad_pcb, pcb.kicad_sch, power.kicad_sch]
2021-02-08 - harware rev 0.1 freeze
    [front_pcb.kicad_pcb, pcb.kicad_pcb]
