zephray/Preader/(notices)

Notices in the files:
hardware/main_pcb/pcb.kicad_pcb:
Copyright 2021 Wenting Zhang
